adafruit/Adafruit-A4988-Breakout-PCB/Adafruit A4988 Breakout.brd

## EAGLE design Adafruit A4988 Breakout.brd (2024-12-13)

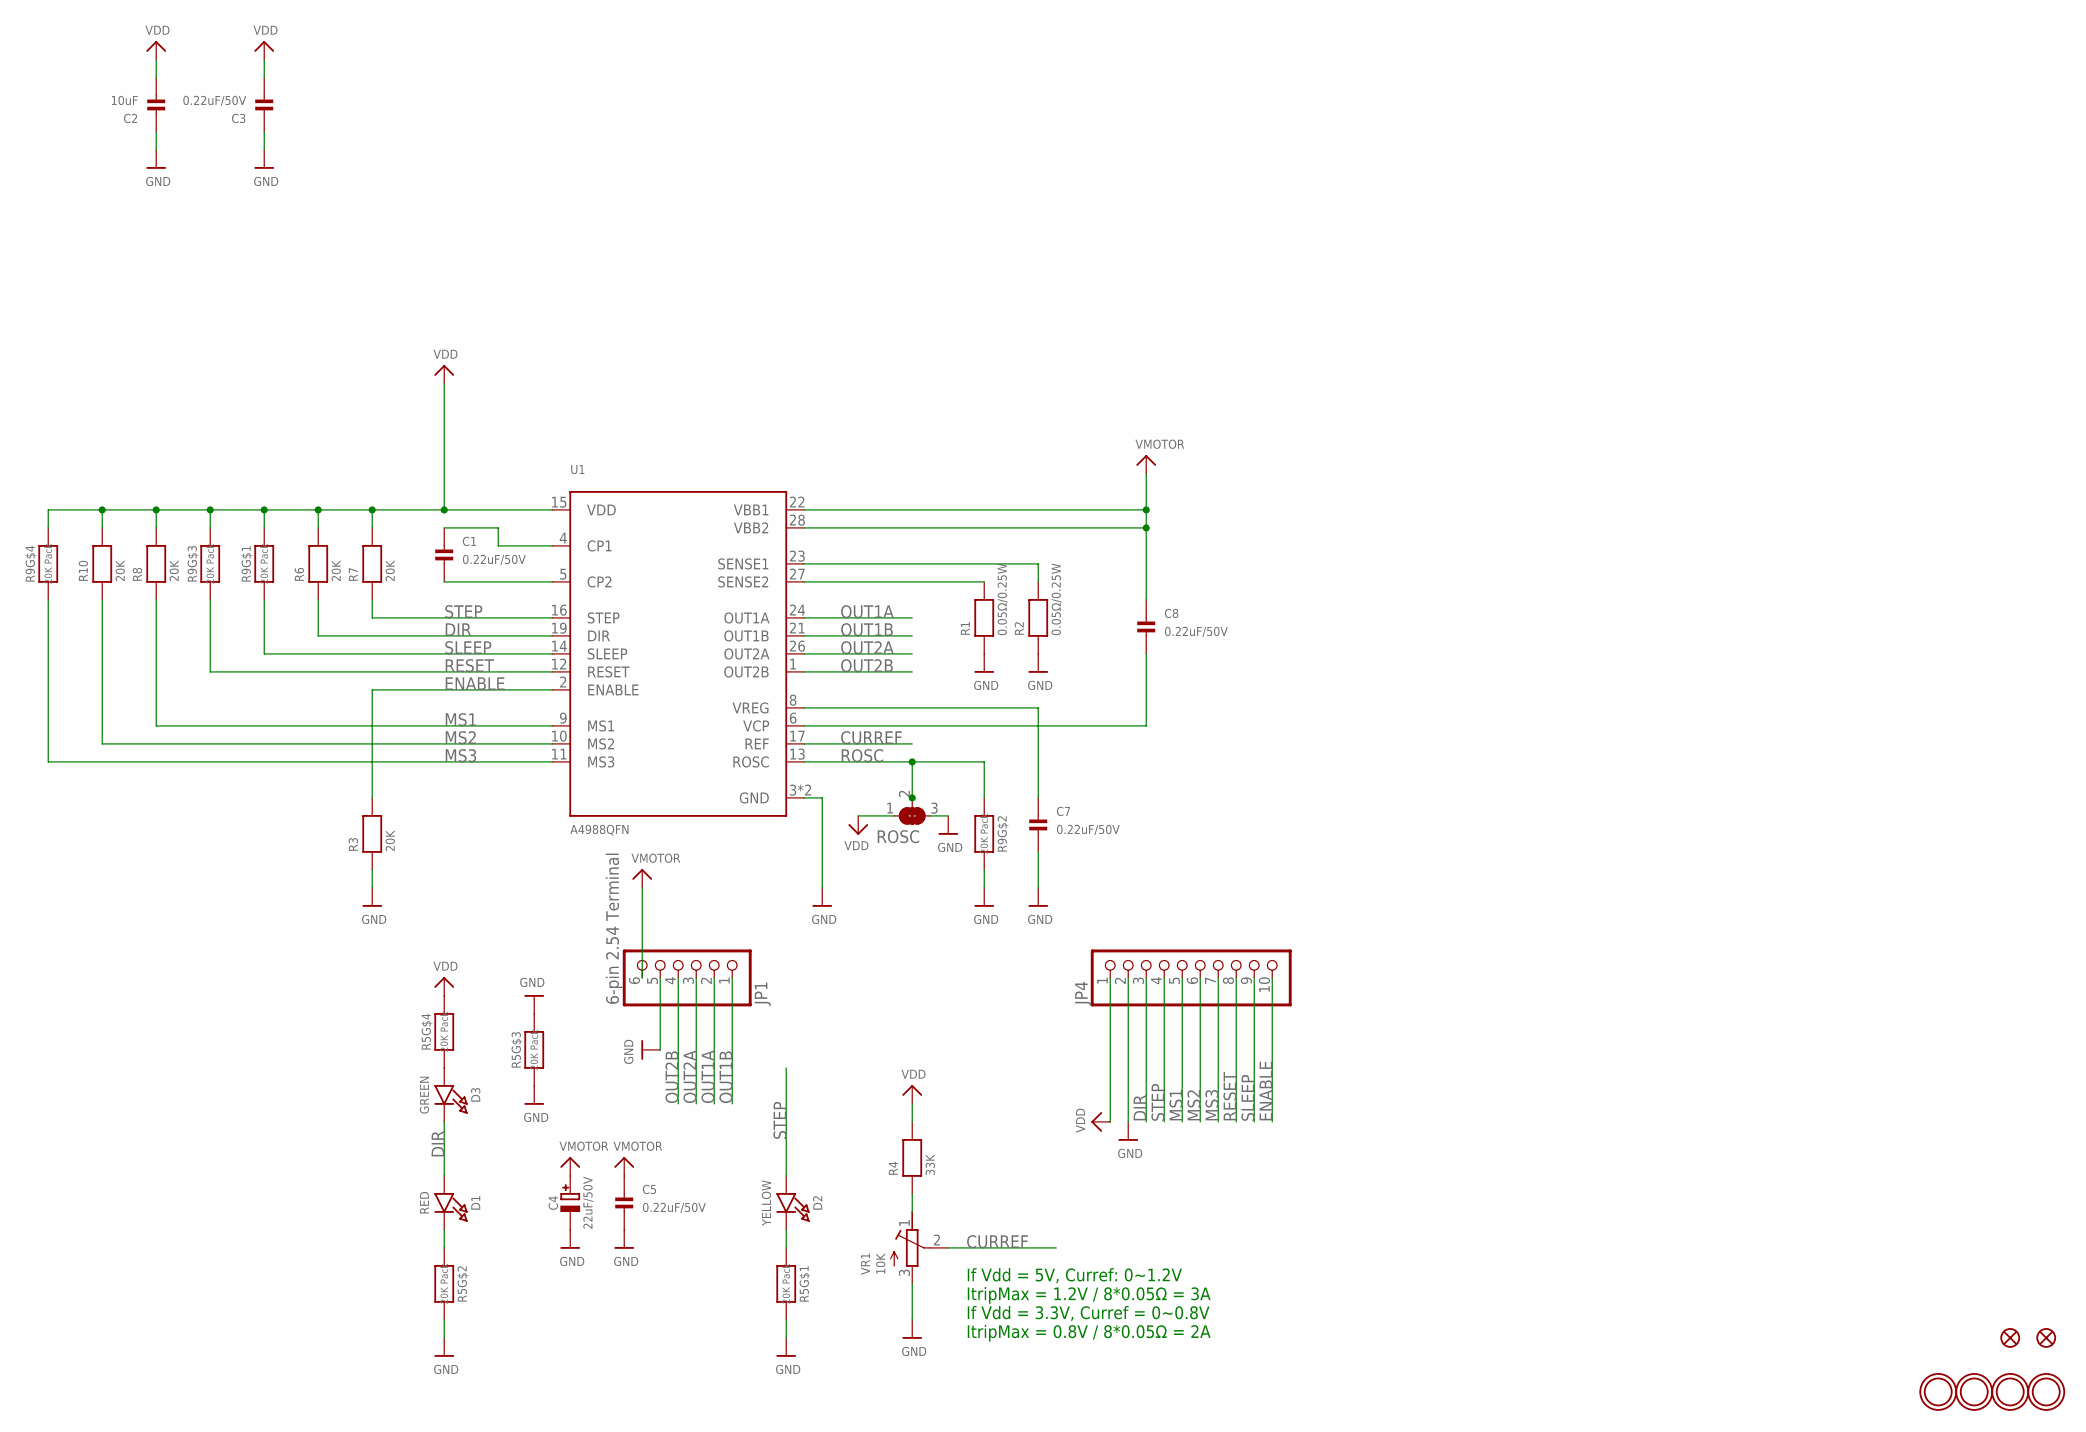
[picture p2: schematic Adafruit A4988 Breakout.sch]

Parts:
C1, C3, C5, C7, C8: 0.22uF/50V; 0603-NO
C2: 10uF; 0805-NO
C4: 22uF/50V; PANASONIC_C
D1: RED; CHIPLED_0603_NOOUTLINE
D2: YELLOW; CHIPLED_0603_NOOUTLINE
D3: GREEN; CHIPLED_0603_NOOUTLINE
JP1: 6-pin 2.54 Terminal; 1X06_2.54MMTERMINAL
JP4: HEADER-1X1070MIL; 1X10_ROUND70
R1, R2: 0.05Ω/0.25W; 0603-NO
R3, R6, R7, R8, R10: 20K; 0603-NO
R4: 33K; 0603-NO
R5, R9: 20K Pack; RESPACK_4X0603
ROSC: SOLDERJUMPER_2WAY; SOLDERJUMPER_2WAY_OPEN_NOPASTE
U1: A4988QFN; QFN28_5MM
U$10, U$11: FIDUCIAL_0.5MM
U$18, U$22, U$26, U$27: MOUNTINGHOLE2.0; MOUNTINGHOLE_2.0_PLATED
VR1: 10K; RTRIM3314J

Connections:
CURREF: U1.17 (REF), VR1.2 (S)
DIR: D1.A, D3.C, JP4.3, R6.1, U1.19 (DIR)
ENABLE: JP4.10, R3.2, U1.2 (ENABLE)
GND: C2.1, C3.1, C4.-, C5.2, C7.2, JP1.5, JP4.2, R1.1, R2.1, R3.1, R5.3 (1), R5.6 (2), R5.7 (2), R5.8 (2), R9.7 (2), ROSC.3, U1.3 (GND), U1.THERMAL (GND), VR1.3 (A)
MS1: JP4.5, R8.1, U1.9 (MS1)
MS2: JP4.6, R10.1, U1.10 (MS2)
MS3: JP4.7, R9.4 (1), U1.11 (MS3)
unnamed: D2.C, R5.1
unnamed: C1.1, U1.4 (CP1)
unnamed: C1.2, U1.5 (CP2)
unnamed: C8.2, U1.6 (VCP)
unnamed: R1.2, U1.27 (SENSE2)
unnamed: R2.2, U1.23 (SENSE1)
unnamed: C7.1, U1.8 (VREG)
unnamed: D1.C, R5.2 (1)
unnamed: R4.1, VR1.1 (E)
unnamed: D3.A, R5.4 (1)
OUT1A: JP1.2, U1.24 (OUT1A)
OUT1B: JP1.1, U1.21 (OUT1B)
OUT2A: JP1.3, U1.26 (OUT2A)
OUT2B: JP1.4, U1.1 (OUT2B)
RESET: JP4.8, R9.3 (1), U1.12 (RESET)
ROSC: R9.2 (1), ROSC.2, U1.13 (ROSC)
SLEEP: JP4.9, R9.1, U1.14 (SLEEP)
STEP: D2.A, JP4.4, R7.1, U1.16 (STEP)
VDD: C2.2, C3.2, JP4.1, R4.2, R5.5 (2), R6.2, R7.2, R8.2, R9.5 (2), R9.6 (2), R9.8 (2), R10.2, ROSC.1, U1.15 (VDD)
VMOTOR: C4.+, C5.1, C8.1, JP1.6, U1.22 (VBB1), U1.28 (VBB2)

Notes on the sheet:
If Vdd = 5V, Curref: 0~1.2V ItripMax = 1.2V / 8*0.05Ω = 3A If Vdd = 3.3V, Curref = 0~0.8V ItripMax = 0.8V / 8*0.05Ω = 2A

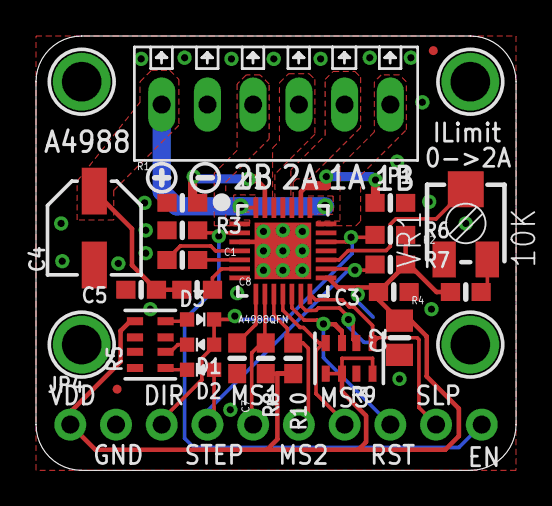
[picture p3: board Adafruit A4988 Breakout.brd from above]

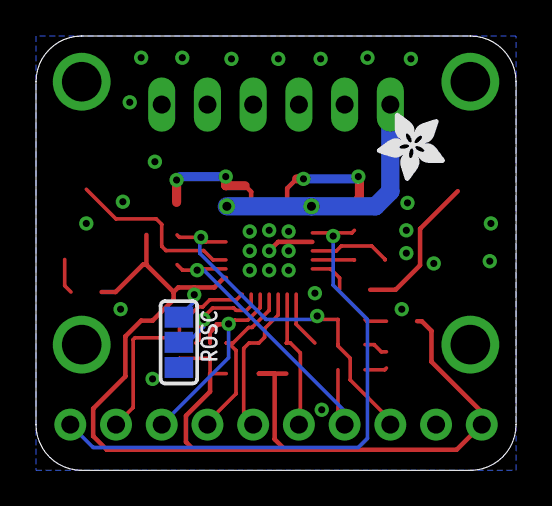
[picture p4: board Adafruit A4988 Breakout.brd from below]

Board: 2 copper layers, 26.7 x 24.1 mm, 34 parts (2 on the bottom side), 27 nets.

Other parts of the board:
U$7: SYMBOL_PLUS
U$8: SYMBOL_MINUS
U$24: ADAFRUIT_3.5MM
